TheBigBoschi/Nixie-Clock-Digital/nixie clock digital.PDF

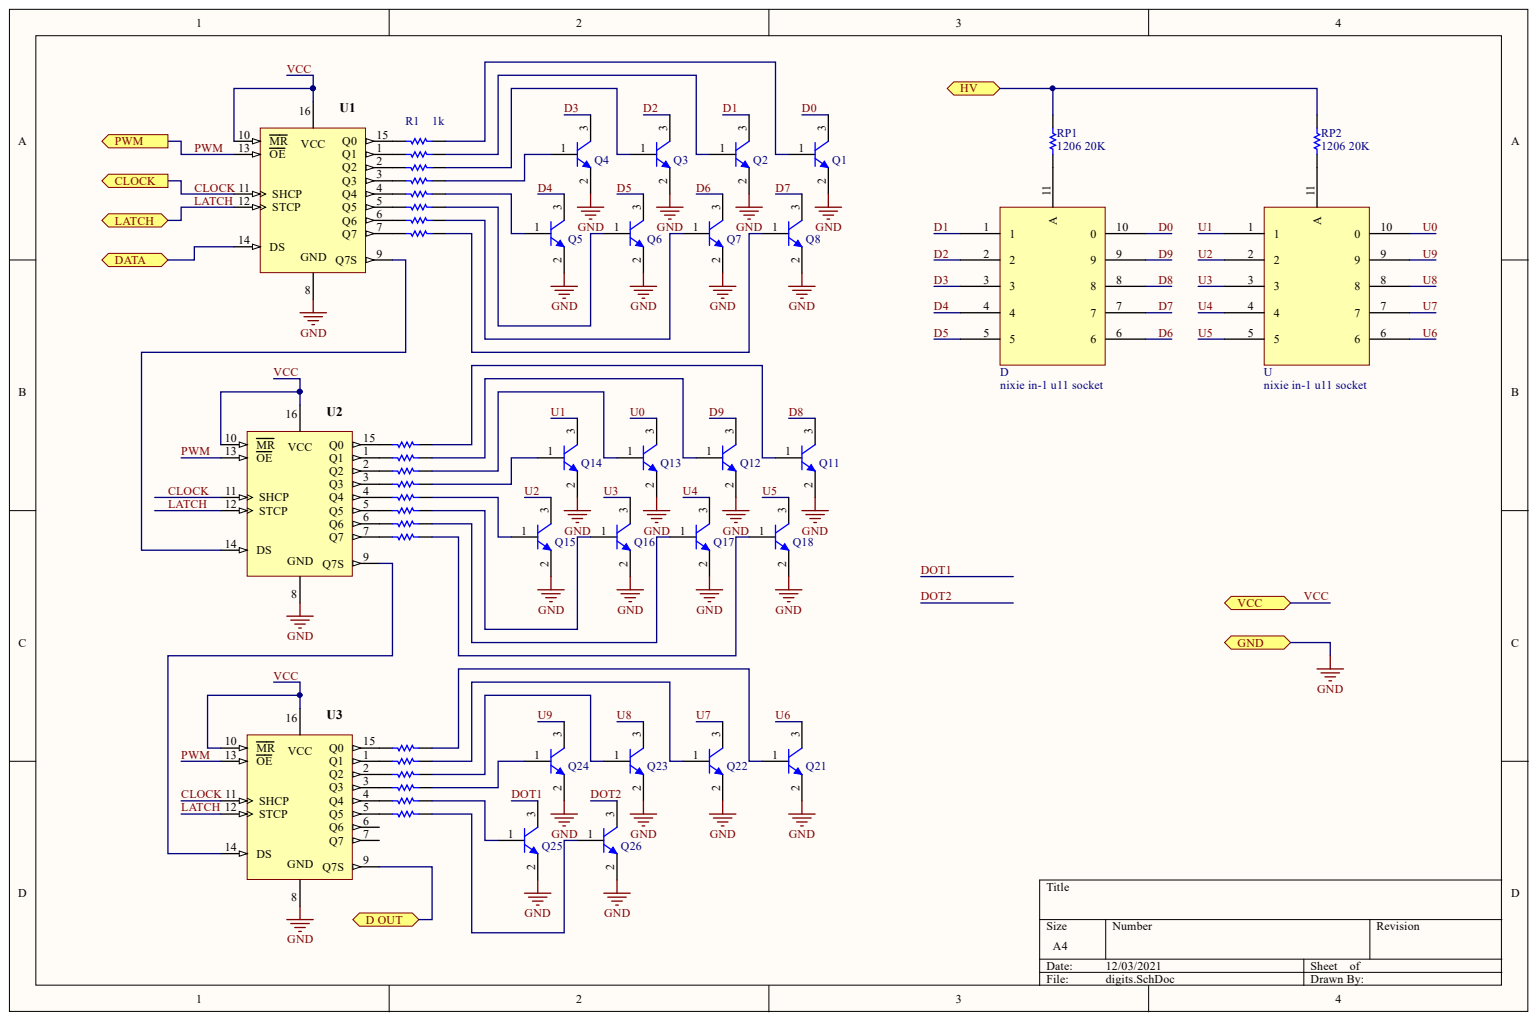
[picture p1: page 1]

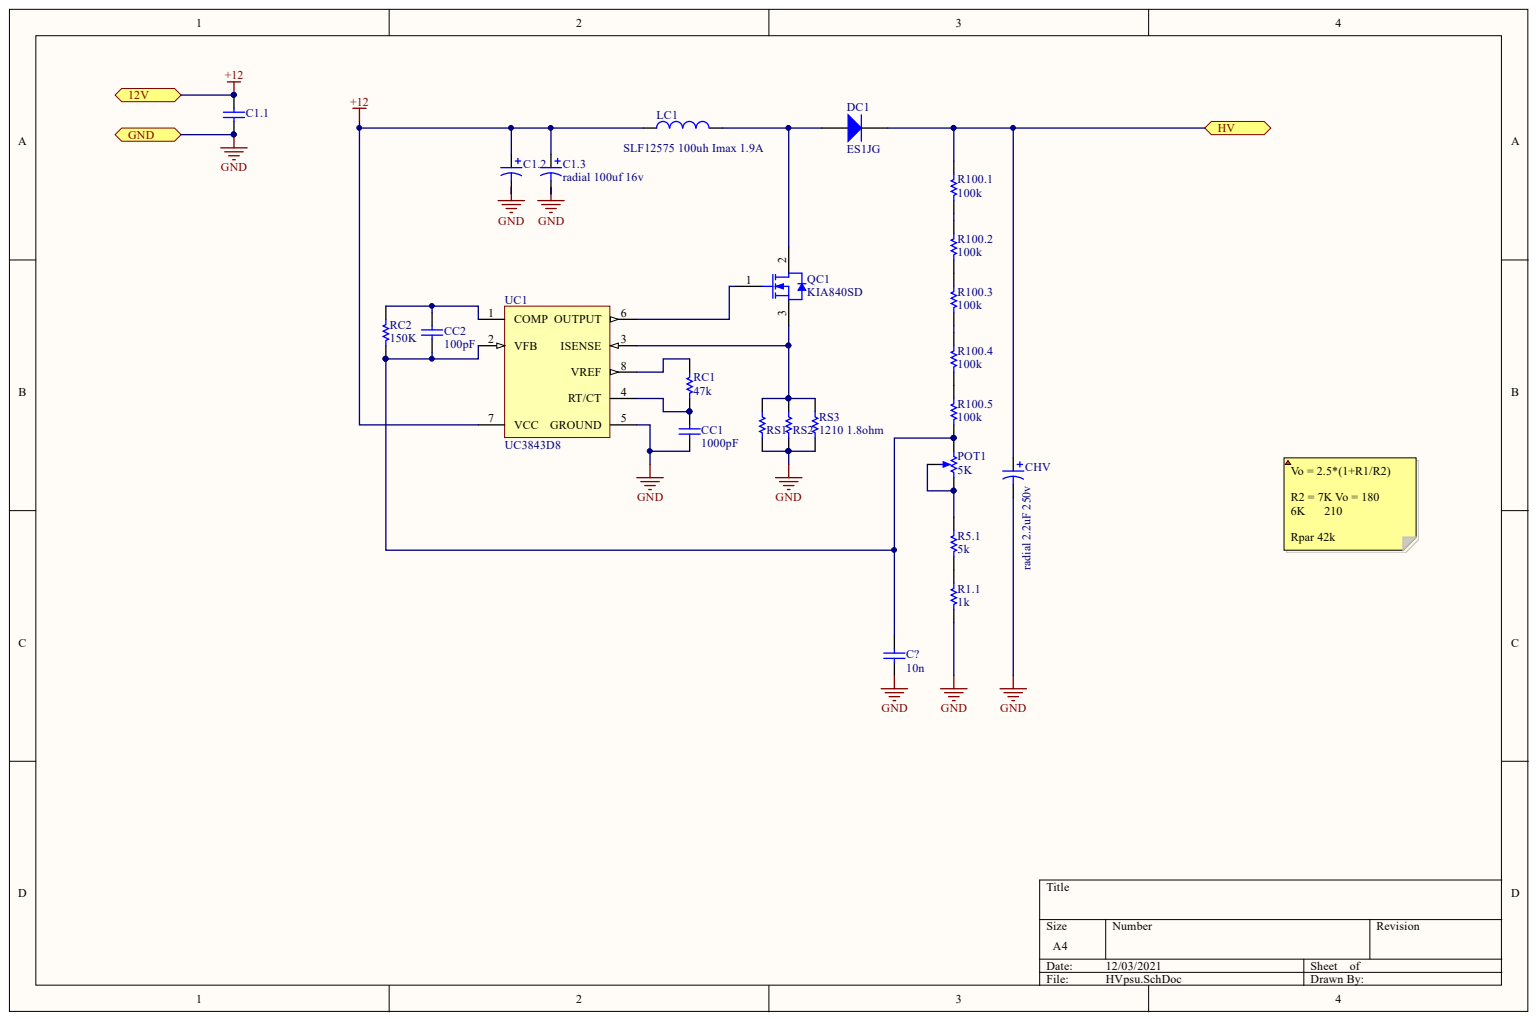
[picture p2: page 2]
Sheet o; h Imax 1.9; QC1 KIA; ial 1; radial 2.2uF 250v; Rpar 4

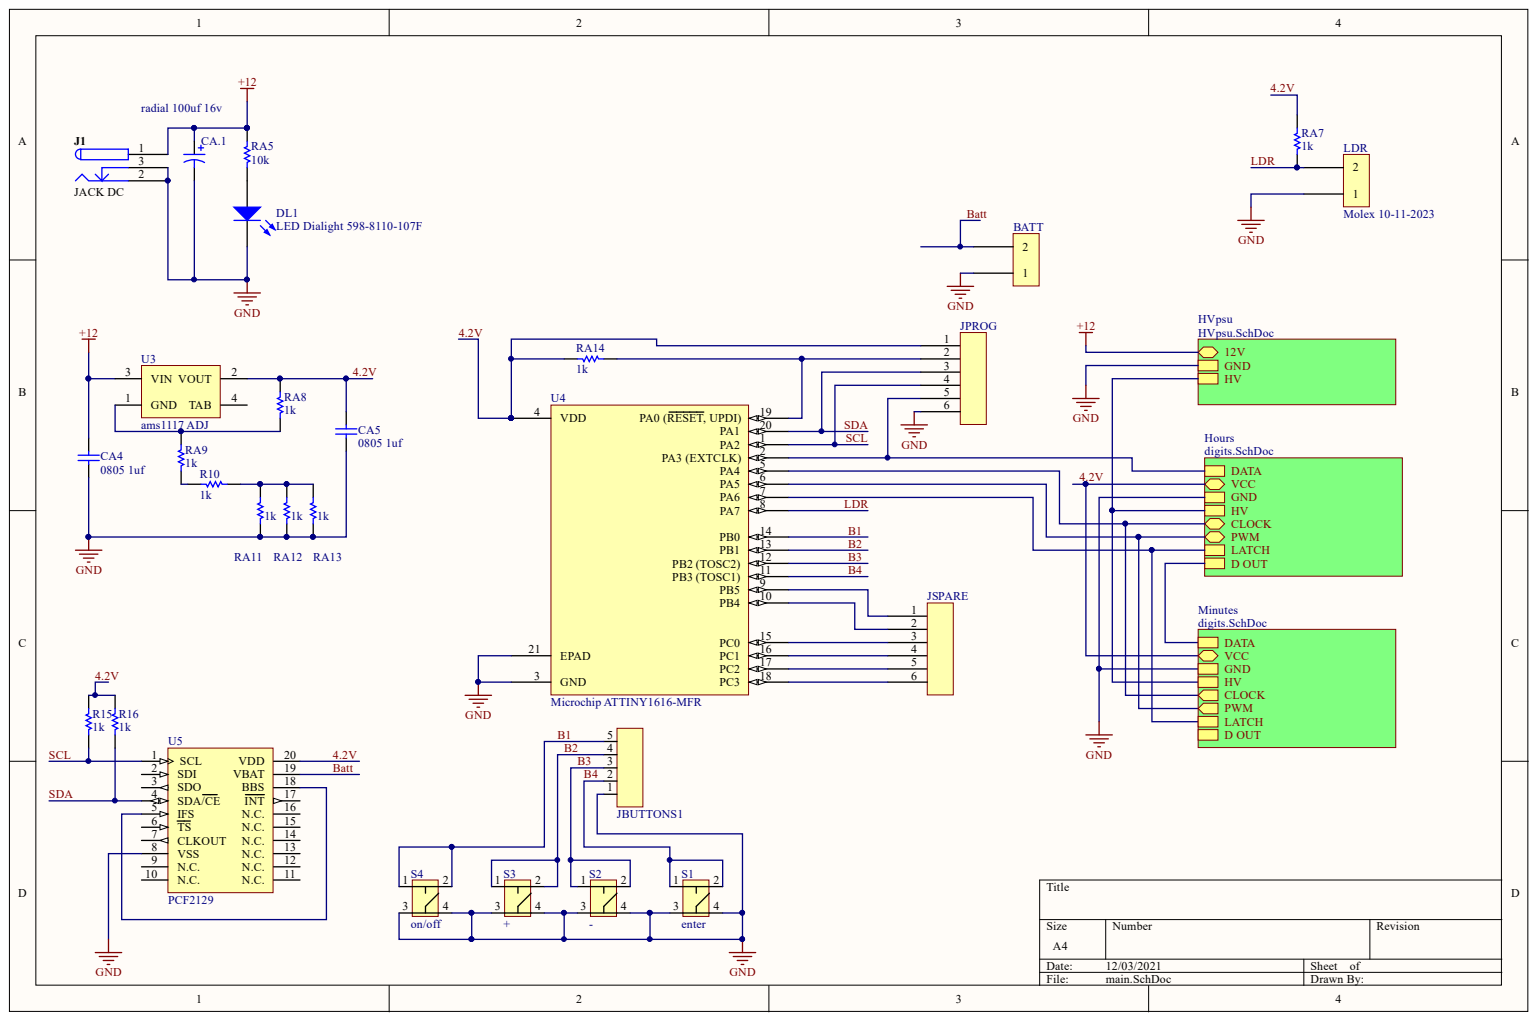
[picture p3: page 3]
Date:; Sheet of; File:; main.SchDoc; Drawn By:; PA3 (EXTCLK); GND 3; VDD 4; 9 PB3 (TOSC1); 11 PB2 (TOSC2); PA0 (RESET, UPDI); EPAD 21; Microchip ATTINY1616-MFR; JACK DC; radial 100uf 16v; SCL 1 SDI 2 SDO 3 SDA/CE 4 IFS 5 TS 6 CLKOUT 7 VSS 8 N.C. 9; 16 INT; 17 BBS; 18 VBAT; 19 VDD; D OUT; Molex 10-11-2023; LED Dialight 598-8110-107F; GND 1; VOUT; 2 VIN 3; ams1117 ADJ

B1
B2

B2 | 4
B3 | 3
B4 | 2

JBUTTONS1

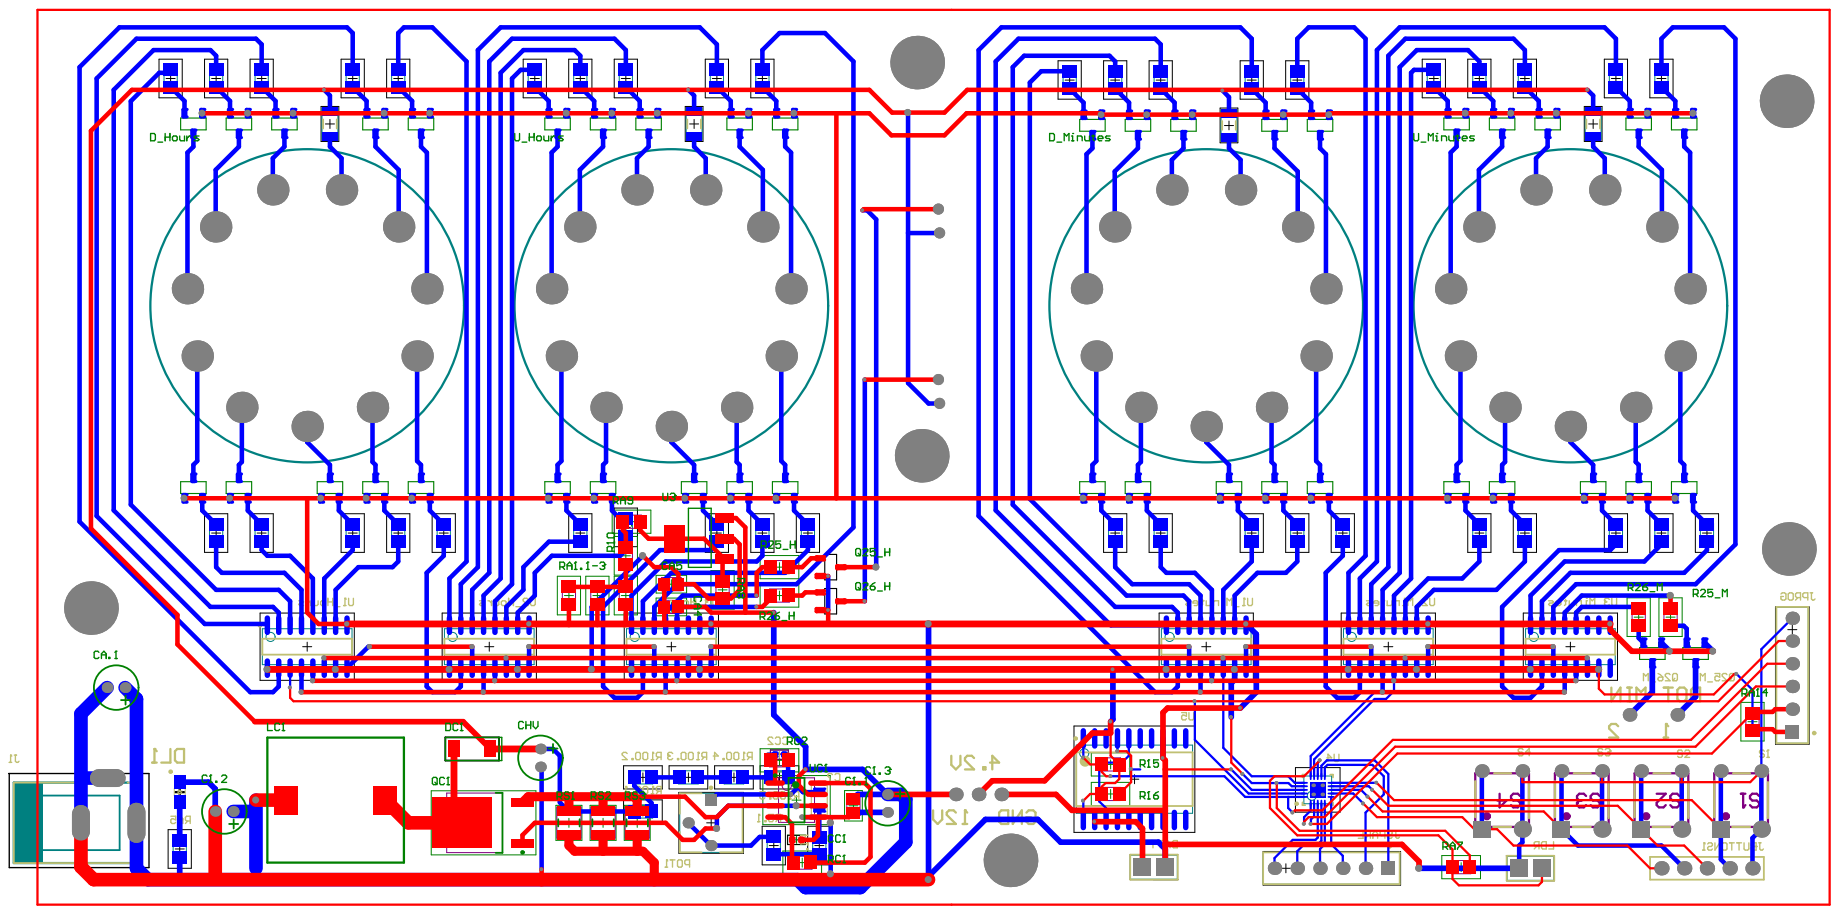
[picture p4: page 4]
